Archita-0927/AtomBerg-/blade_plan_dimensioned (1).png

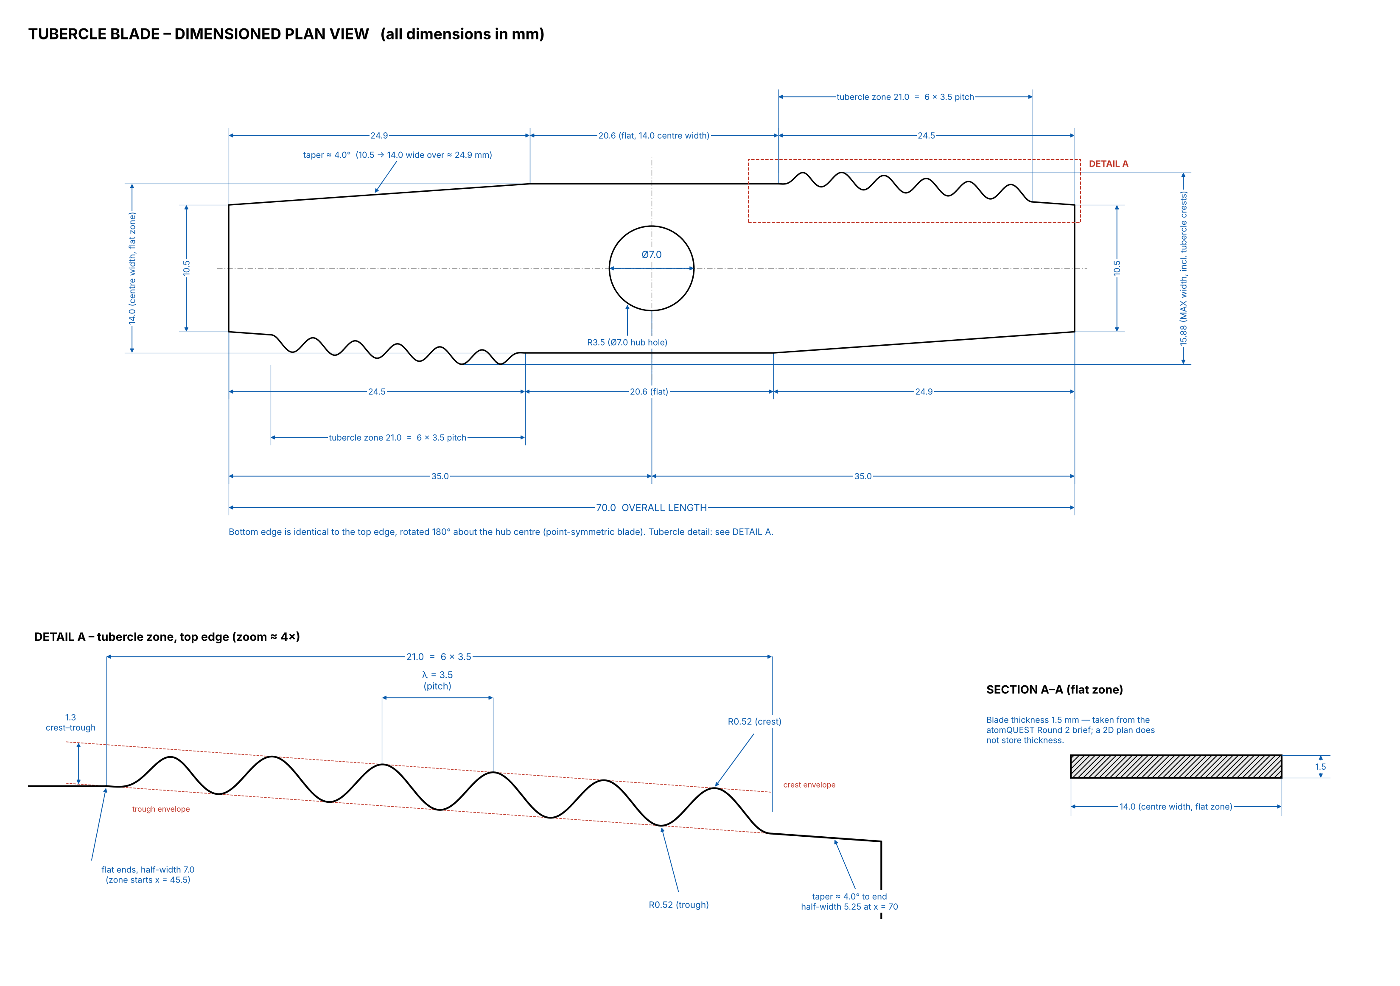
blade_plan_dimensioned (1).png
