Archita-0927/AtomBerg-/hybrid_blade_planform_dimensioned (1).png

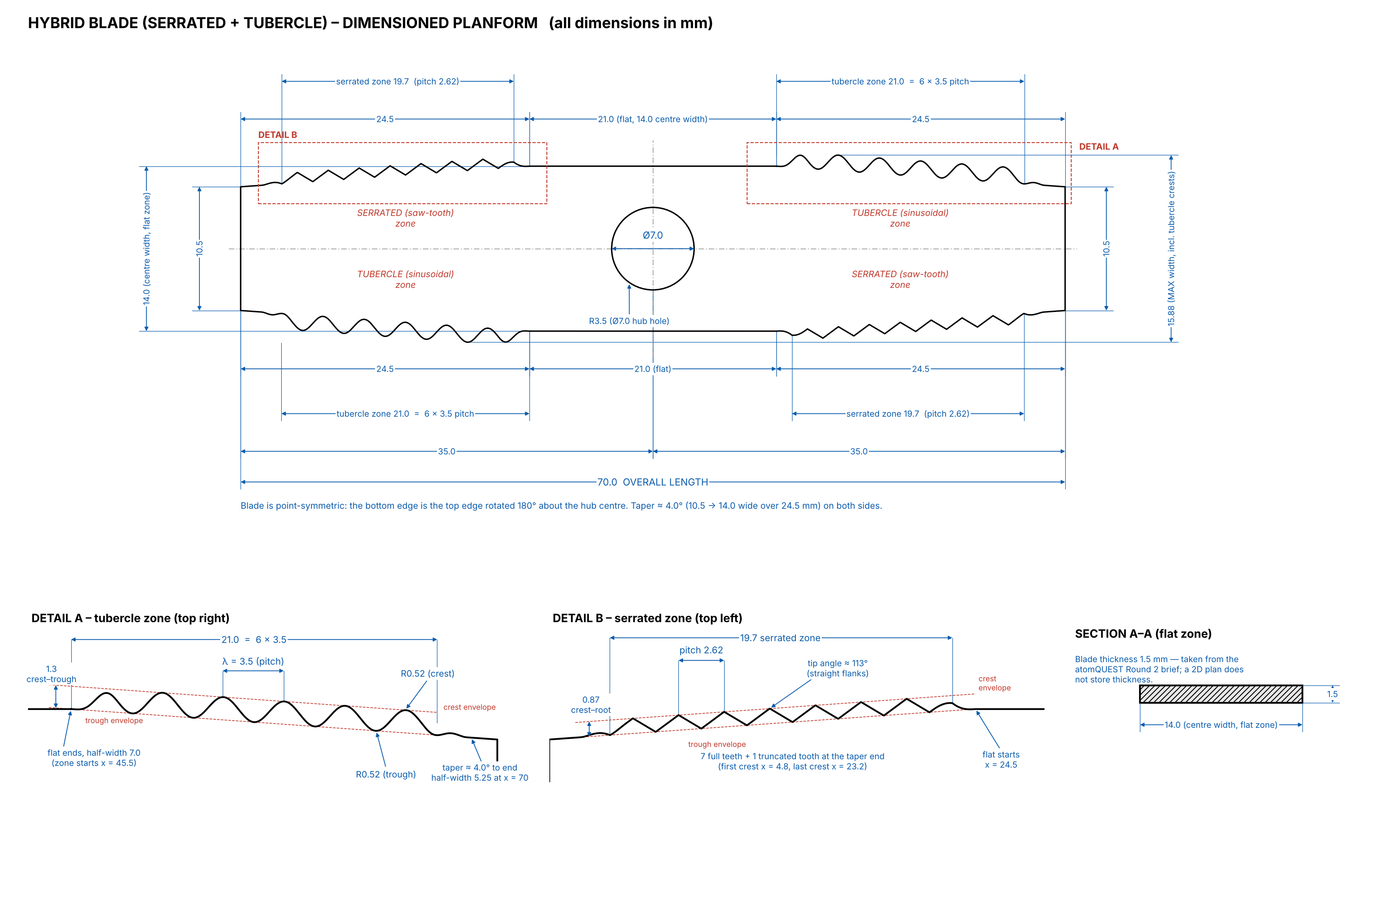
hybrid_blade_planform_dimensioned (1).png
