Archita-0927/AtomBerg-/(list of files, cad)

Other CAD files:
blade plan.dwg
scale hybrid blade_planform (1).dwg
